Ritbit/SIGHT/SIGHT Power&Data V2.1c - Schematics & PCB/README.md

            
How to use in EasyEDA：

In the editor, open the document via: Top menu - File - Open - EasyEDA... and select the json file, then open it at the editor, you can save it into a project.

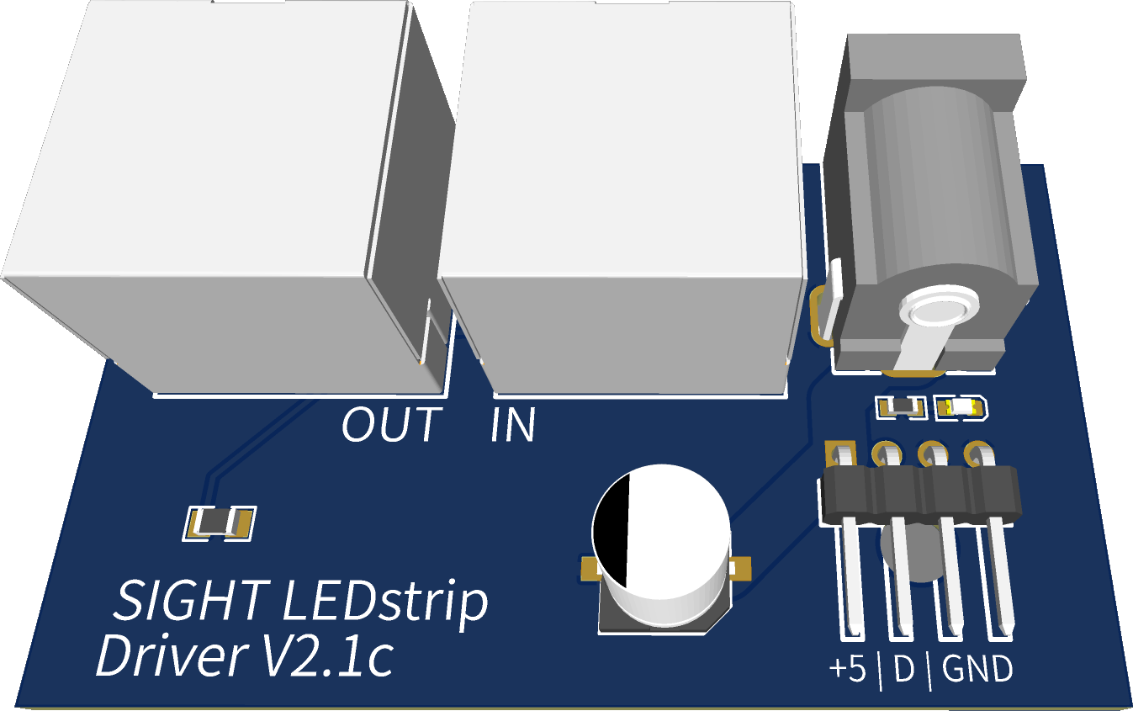
[picture p4: images/Data+Power-PCB-1.png]

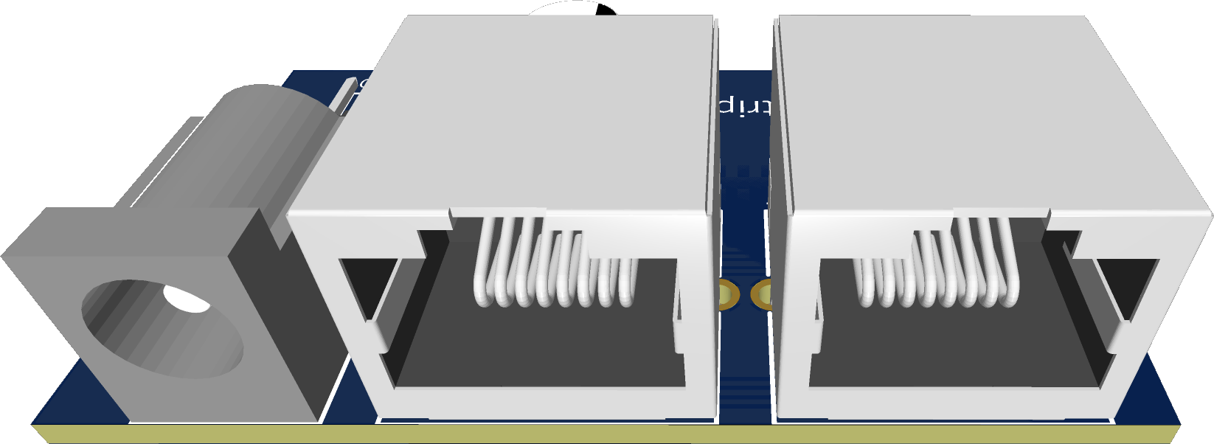
[picture p5: images/Data+Power-PCB-2.png]
