Ritbit/SIGHT/SIGHT controller V2.1c - Schematics & PCB/README.md

            
How to use in EasyEDA：

In the editor, open the document via: Top menu - File - Open - EasyEDA... and select the json file, then open it at the editor, you can save it into a project.

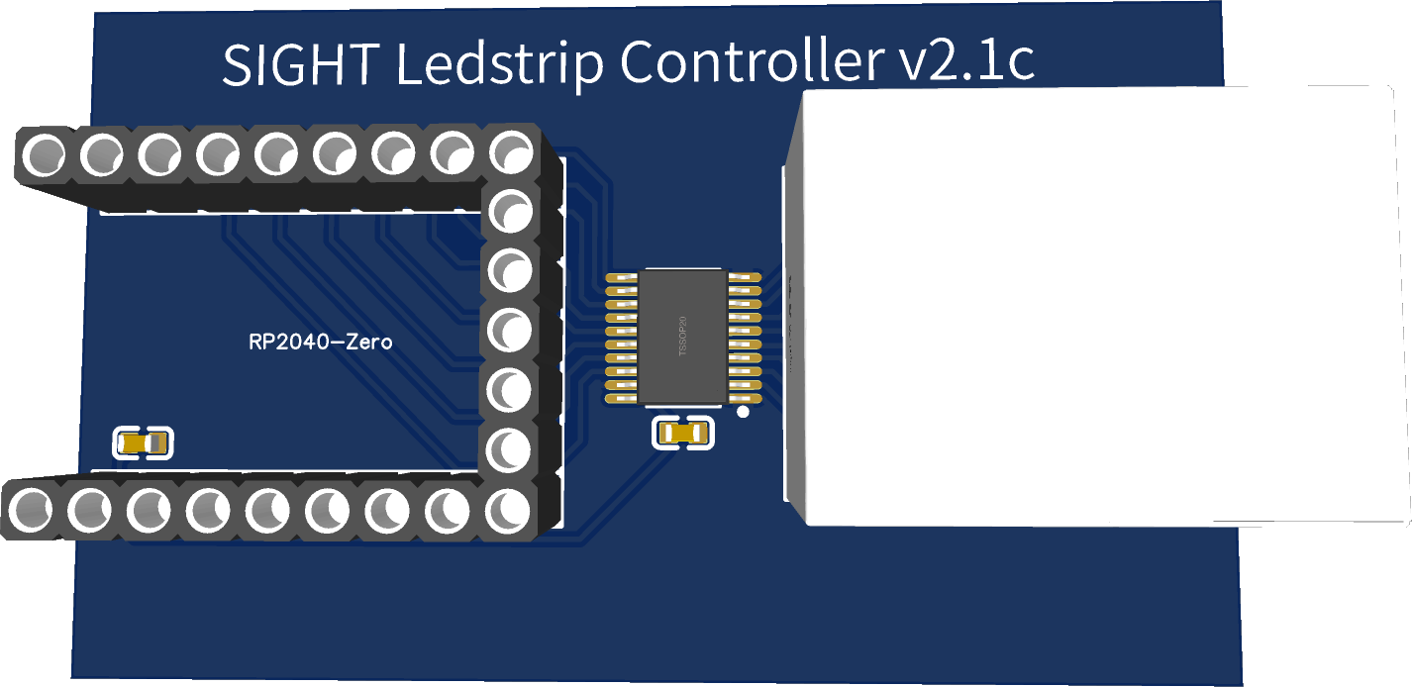
[picture p6: images/Controller-PCB.png]
Controller-PCB Zero
