Ritbit/SIGHT/images/ws2812_timing.png

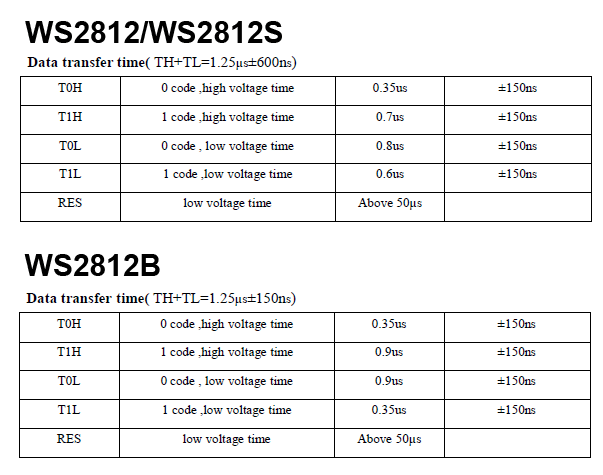
images/ws2812_timing.png
