Ritbit/SIGHT/images/testrack.jpg

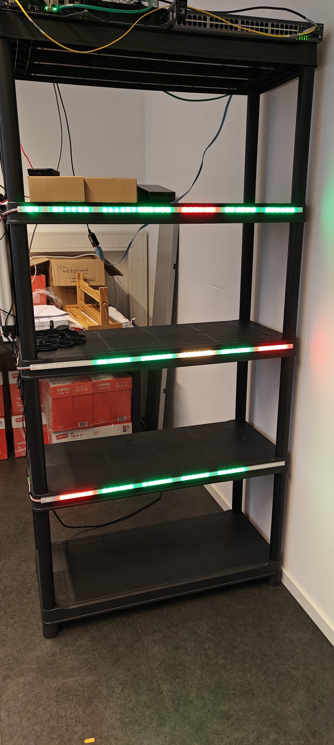
images/testrack.jpg
