Ritbit/SIGHT/SIGHT controller V2.1c - Schematics & PCB/PCB SIGHT Controller V2.1c Bottom Layer.pdf

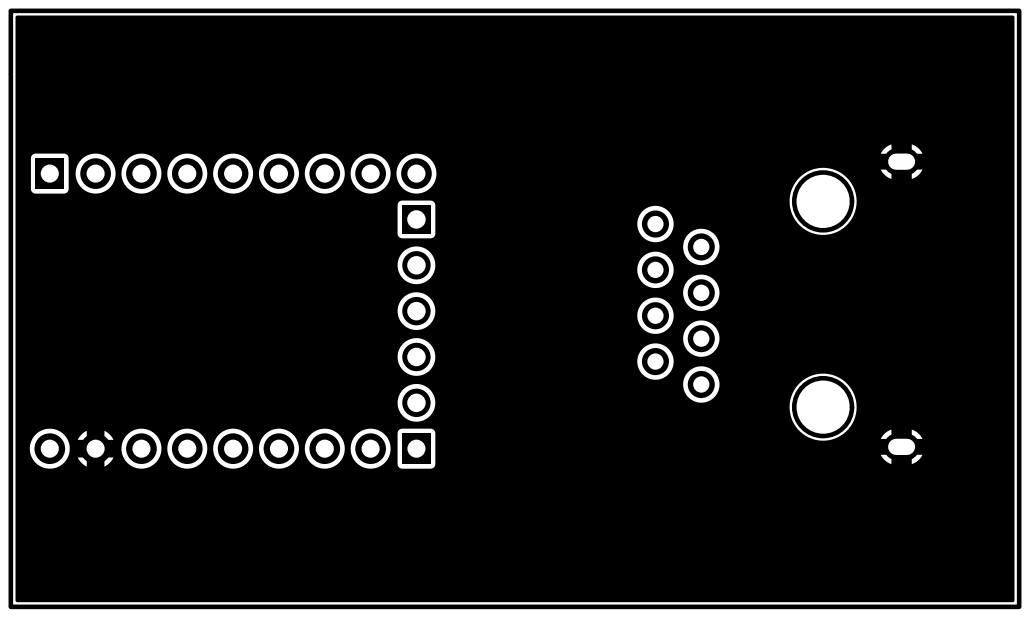
[picture p9: page 1]
