Ritbit/SIGHT/SIGHT controller V2.1c - Schematics & PCB/PCB SIGHT Controller V2.1c Top Layer.pdf

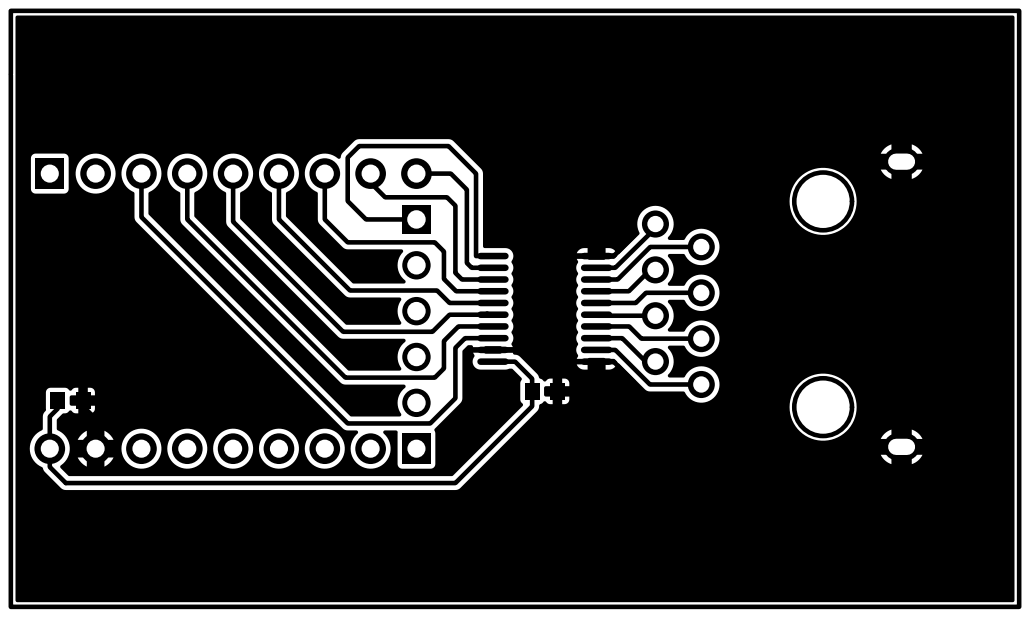
[picture p10: page 1]
