Ritbit/SIGHT/SIGHT controller V2.1c - Schematics & PCB/PCB SIGHT Controller V2.1c Top Silk Layer.pdf

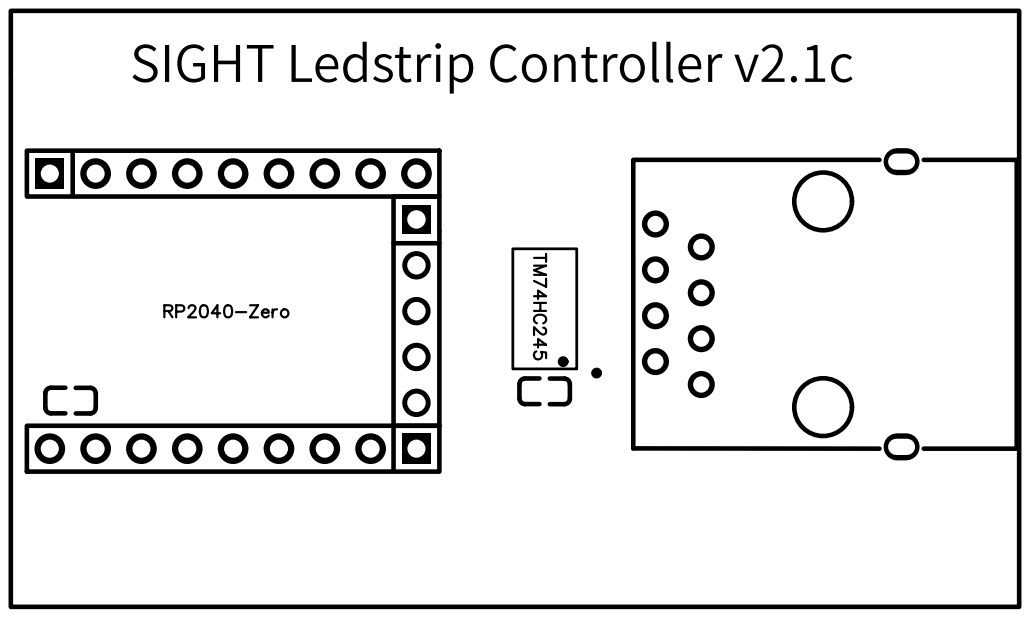
[picture p11: page 1]
