Ritbit/SIGHT/SIGHT controller V2.1c - Schematics & PCB/Schematic SIGHT Controller-V2.1c.pdf

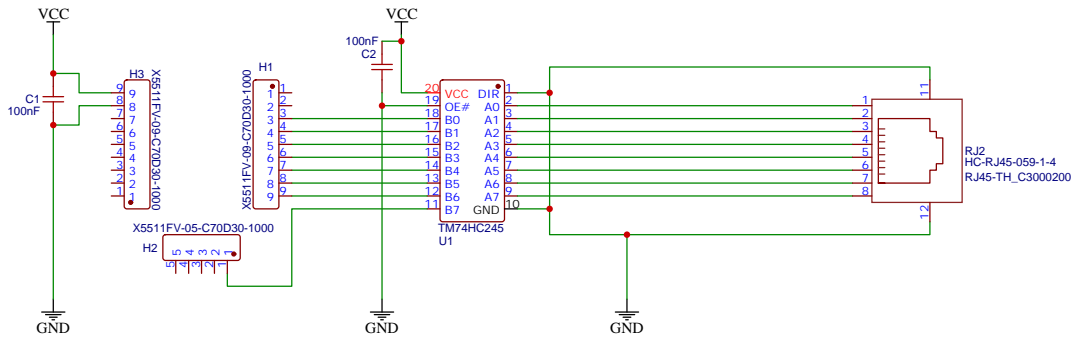
[picture p12: page 1]

Drawn By: B. van Ritbergen
