Ritbit/SIGHT/SIGHT Power&Data V2.1c - Schematics & PCB/PCB SIGHT Power&Data V2.1c Bottom Layer.pdf

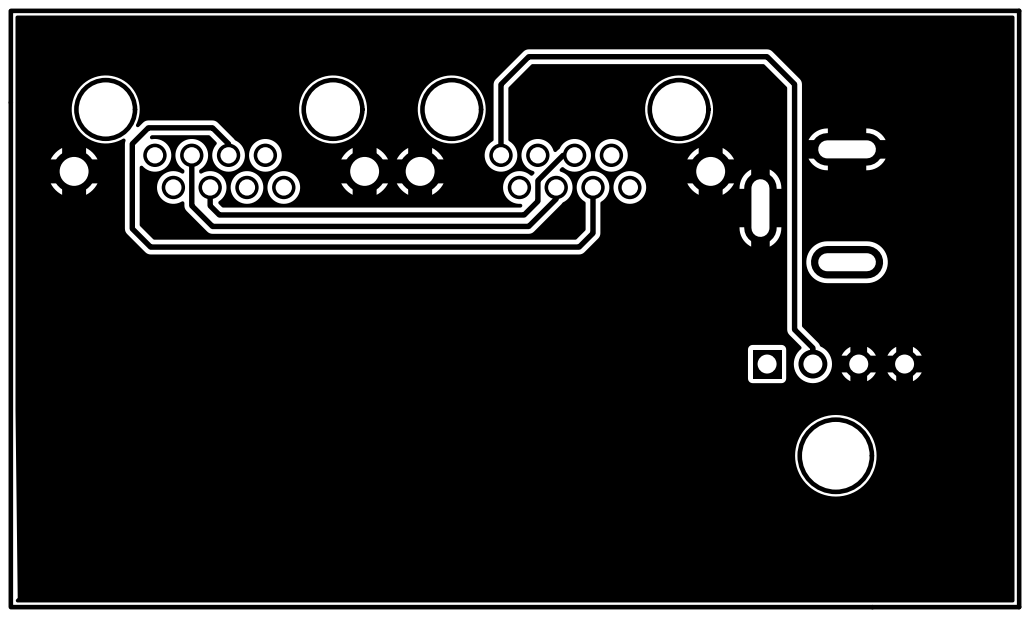
[picture p13: page 1]
