Ritbit/SIGHT/SIGHT Power&Data V2.1c - Schematics & PCB/PCB SIGHT Power&Data V2.1c Top Layer.pdf

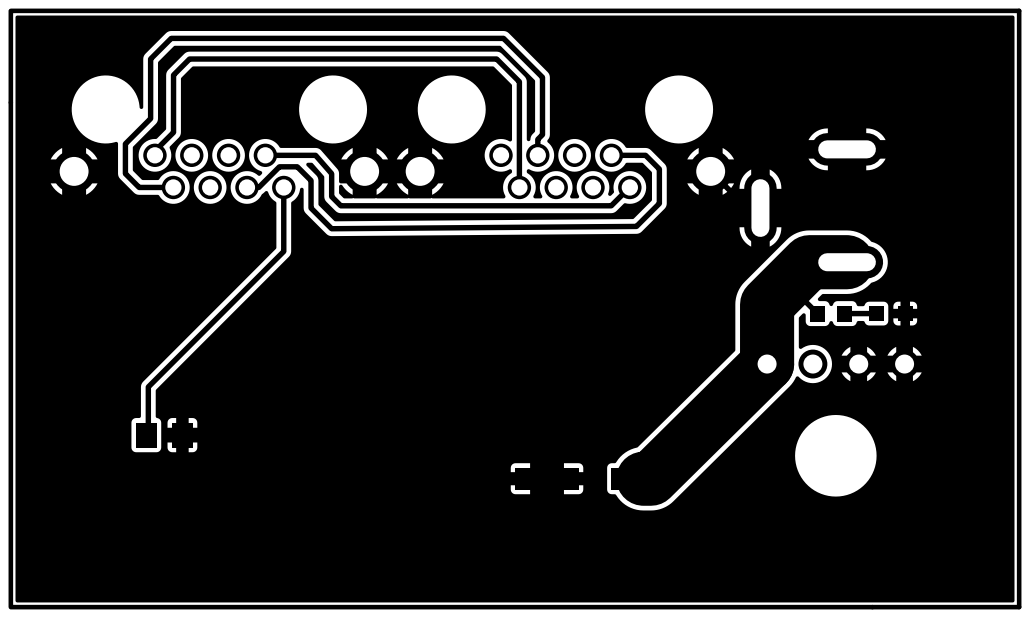
[picture p14: page 1]
