Ritbit/SIGHT/SIGHT Power&Data V2.1c - Schematics & PCB/PCB SIGHT-Power&Data V2.1c Top Silk Layer.pdf

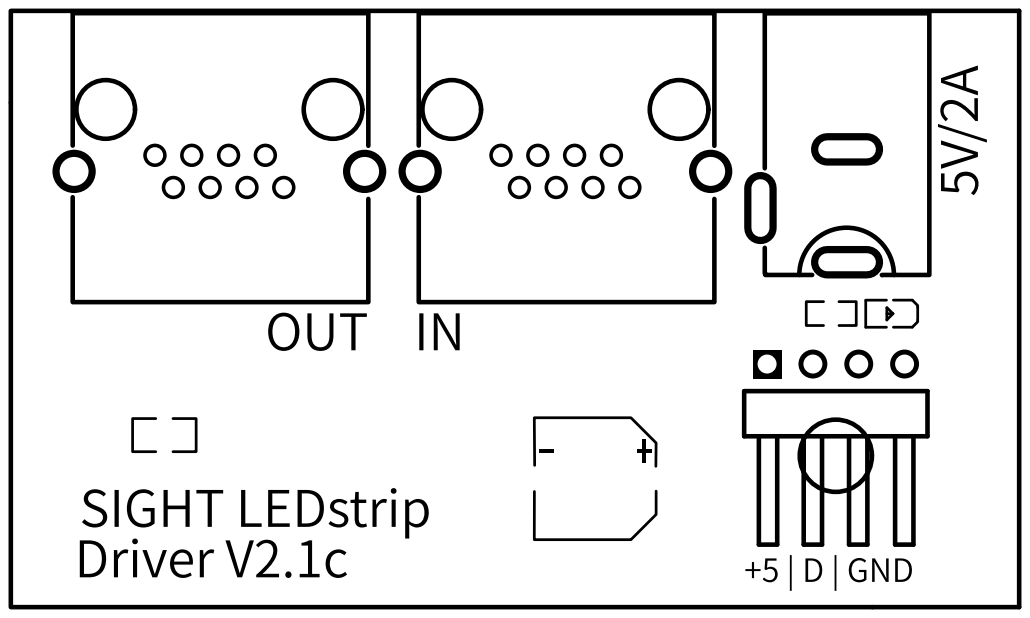
[picture p15: page 1]
