Ritbit/SIGHT/SIGHT Power&Data V2.1c - Schematics & PCB/Schematics SIGHT Power&Data V2.1c.pdf

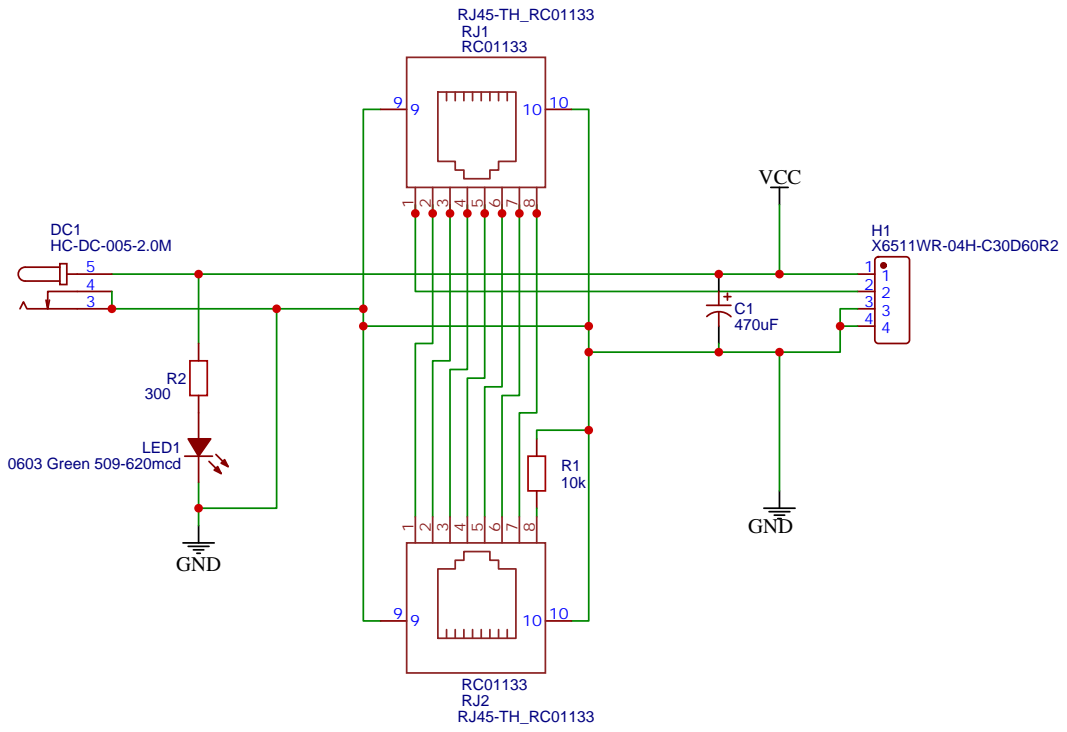
[picture p16: page 1]

Drawn By: B. van Ritbergen
