Ritbit/SIGHT/(list of files, drawings)

Other design files:
SIGHT controller V2.1c - Schematics & PCB/PCB SIGHT Controller PCB V2.1c.json
SIGHT controller V2.1c - Schematics & PCB/Schematic SIGHT controller V2.1c.json
SIGHT Power&Data V2.1c - Schematics & PCB/PCB SIGHT Power&Data PCB V2.1c.json
SIGHT Power&Data V2.1c - Schematics & PCB/Schematic SIGHT Power&Data V2.1c.json
