Ritbit/SIGHT/(commit log)

2024-10-10 Added Schematics and PCB layouts
    [PCB SIGHT Controller PCB V2.1c.json, PCB SIGHT Power&Data PCB V2.1c.json, Schematic SIGHT Power&Data V2.1c.json, Schematic SIGHT controller V2.1c.json]
2024-10-10 Added note about disfunctional RGBW LEDstrips
2024-10-14 Renamed dirs
    [PCB SIGHT Controller PCB V2.1c.json, PCB SIGHT Power&Data PCB V2.1c.json, Schematic SIGHT Power&Data V2.1c.json, Schematic SIGHT controller V2.1c.json]
2024-10-20 Some fixes and adaptations
    [sight.ino]
2024-10-20 Added ledstrip image
2024-10-21 Update PCB README.txt
2024-10-21 Renamed folders
    [PCB SIGHT Controller PCB V2.1c.json, PCB SIGHT Power&Data PCB V2.1c.json, Schematic SIGHT Power&Data V2.1c.json, Schematic SIGHT controller V2.1c.json]
2024-11-09 Renamed src to stay compatible with ArduinoIDE
2025-09-24 Changes & fixes -> 1.7beta
    [sight.ino]
2025-11-25 Fixed small bug in setting identifier.
    [sight.ino]
2025-11-25 Fixed unnecessary blank lines in output
    [sight.ino]
2025-11-26 Fix fading and cosmetic issue on show config
    [sight.ino]
2025-12-04 Fixed some spelling typos
    [sight.ino]
2026-09-28 v1.10: fix config validation, CPU LED timing, and boot-wait bugs
    - Fix group-ID truncation, geometry/division-by-zero, and unvalidated
    config load/import via a shared validateConfig()
    - Fix CPU LED bit-bang timing (was showing solid white) and restore
    indefinite serial-connect wait on boot
    - Harden serial parsers, make LittleFS/config saves safer, close an
    ISR/foreground race
    Note: a new persisted formatId field means an existing config.bin saved
    by older firmware will be flagged/reset to defaults on first boot after
    upgrading; use 'S' to save a fresh config afterward.
    [sight.ino]
2026-09-28 v1.11: field-wise persistence, reboot confirmation, hardware-verified CPU LED/RGBW timing
    - Replace raw-struct Se/Li/flash persistence with field-wise encodeConfig()/decodeConfig()
    - Cl/Cx now ask to save+reboot (Y/N) instead of a passive notice or auto-reboot
    - CPU LED timing hardware-verified in spec with a DIY logic analyzer; fixed a real bug found along the way (redundant frame resend) and reverted an optimization that broke real hardware
    - Added CPULED_COLOR_ORDER: two spare boards needed GRB, not RGB, for their onboard chip (genuine hardware variance)
    - RGBW wire order hardware-verified as G,R,B,W; documented that LED_COLOR_ORDER doesn't control it
    - FastLED_RGBW.h dead-code cleanup
    [sight.ino]
2026-09-28 Clarify the reboot Y/N prompt's fallback comment
    The comment claimed an unrecognized answer "falls through" to be
    parsed as a normal command, but the unconditional return right after
    the if/else-if/else discards the line instead. Fix the comment to
    describe what actually happens.
    [sight.ino]
2026-09-28 Fix V command's misleading RGBW color order string
    V echoed LED_COLOR_ORDER's value (RGB) as the RGBW wire color order,
    but that define has no effect in RGBW mode -- FastLED.addLeds() is
    called with a (CRGB*)-cast CRGBW buffer, so its color-order swap never
    sees the real 4-byte layout. Print the real, hardware-verified fixed
    order (GRBW, from CRGBW's field declaration order) instead.
    [sight.ino]
2026-09-28 Flag Li:CONFIG: imports that change LED count or GPIO pins for reboot
    Cl/Cx ask to save+reboot when changed interactively, because FastLED's
    controllers are registered once at boot. Importing a whole config via
    Li:CONFIG: could change those same two fields but only got a generic
    S/R reminder. Compare the imported (and validated) values against the
    live config before overwriting, and use the same promptSaveAndReboot()
    flow as Cl/Cx when either actually changed.
    [sight.ino]
2026-09-28 Fix animate_Step[] race in patterns 8-12
    boundAnimateStep() bounds an animate_Step[] element atomically, but
    patterns 8-12 then re-read animate_Step[pattern] directly afterward
    (unprotected) to compute an LED index. The animateStep() ISR can fire
    in that gap and drift the value 1 past the bound just applied, which
    in the worst case (last group in a channel, numLedsPerChannel at max)
    is a narrow out-of-bounds write.
    Have boundAnimateStep() return the bounded value and have every caller
    use that local instead of re-reading the array.
    [sight.ino]
2026-09-28 Validate combined LED strip geometry in Cl/Ct/Cw/Co
    Each of these setters only range-checked its own value, not the
    combined geometry invariant (positive segment width, spacer narrower
    than the segment, last group within numLedsPerChannel) that
    validateConfig() enforces elsewhere. A sequence of individually-valid
    commands could leave LedConfig in a combination validateConfig() would
    have rejected -- setLEDGroup()'s render-time bounds check kept this
    from corrupting memory, but rendering could silently go wrong.
    Extract the combined-geometry check into isValidGeometry(), share it
    with validateConfig(), and reject the change from Cl/Ct/Cw/Co with the
    proposed value substituted in if the resul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
    [sight.ino]
2026-09-28 Don't bump CONFIG_IDENTIFIER for v1.11 -- layout is unchanged from v1.10
    v1.11 replaced raw-struct persistence with an explicit field-wise
    encodeConfig()/decodeConfig(), but that only changed the serialization
    mechanism, not the actual LedData layout: the struct is byte-for-byte
    identical to v1.10 (same fields, same order, same types), and
    sizeof(LedData) == CONFIG_WIRE_SIZE == 112 with no padding, verified at
    compile time. So the previous CONFIG_IDENTIFIER bump to
    "SIGHT-CFG1.11" wasn't backed by an actual incompatibility -- it just
    made validateConfig() flag every existing v1.10 config.bin as a
    "format identifier mismatch" and print a misleading "Some Values were
    out of range and corrected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
    [sight.ino]
2026-09-29 v1.12: native FastLED RGBW support, live RGB/RGBW + LED-count switching
    - Replace the compile-time USE_RGB_LEDS/USE_RGBW_LEDS toggle and the
    hand-rolled FastLED_RGBW.h CRGB-cast hack with FastLED's own native
    RGBW support (CLEDController::setRgbw()/clearWhiteChannel(), checked
    fresh on every show() by the RP2040 PIO driver). One firmware build
    now supports both modes; leds[][] is always plain CRGB.
    - New Cm:RGB/Cm:RGBW command switches strip mode live, no reboot.
    LED_COLOR_ORDER is now genuinely honored in RGBW mode (it wasn't
    before, under the old cast hack). RGBW uses kRGBWExactColors:
    extracts the shared gray component into W and subtracts it from
    R/G/B, reducing current d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
    [sight.ino]
2026-09-29 Make CPU LED color order runtime-configurable and persisted
    CPULED_COLOR_ORDER (RGB/GRB, for the onboard status LED chip) was
    compile-time only, requiring a recompile+reflash whenever a board's
    onboard chip variance was found. Added LedData.cpuLedColorOrder plus a
    new Cq:RGB/Cq:GRB command so this can be corrected with one command +
    S, no rebuild needed -- sendRGB_CPULED() now branches on the runtime
    field instead of an #if. CPULED_COLOR_ORDER stays as the compile-time
    default (used by resetToDefaults() and validateConfig()'s fallback).
    LedData gains a field, so CONFIG_WIRE_SIZE grew 113 -> 114 bytes;
    encodeConfig()/decodeConfig()/validateConfig()/resetToDefaults() all
    updated to match. Ver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
    [sight.ino]
2026-09-29 Update README for v1.12: single-build RGBW, new commands, version history
    - LED strip type is now a runtime Cm:RGB/Cm:RGBW command instead of a
    firmware #define; removed the now-nonexistent FastLED_RGBW library
    from the install list
    - Fixed the command reference: replaced the long-broken C4: entry with
    Cm:/Cq:, and noted which commands still require a reboot
    - Updated the sample boot/config output to match current firmware
    (v1.12 field names, default values)
    - Added version history sections for v1.10, v1.11, and v1.12 (was
    stuck at v1.9.1)
2026-09-29 Fix 4 issues found by a post-release CodeRabbit audit
    - animate_Step[] was uint8_t, capping chase-pattern animation at 255
    steps: boundAnimateStep()'s "% modulus" became a no-op whenever
    modulus (e.g. groupWidth*2 for pattern 10) reached 256+, permanently
    truncating patterns 8/9/10/12 on wide LED groups. Widened
    animate_Step/boundAnimateStep()'s return/the setLEDGroup() step
    locals to uint16_t, and fixed animateStep()'s init loop to iterate
    array elements instead of raw bytes (was relying on
    sizeof(animate_Step) counting single-byte elements).
    - Li:CONFIG: import, the runtime L reload, and Cd only called
    applyLedCount()/applyLedMode() after replacing the whole LedConfig,
    un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
    [sight.ino]
2026-09-29 Fix stale default LED count in README sample boot output
    The sample output still showed 57 (the old NUM_LEDS_PER_CHANNEL_DEFAULT)
    after it was changed to 60 in sight.ino.
2026-09-29 Address review remarks: dead variable, stale changelog entries
    - Removed unused CRGB color local in StartupLoop() (assigned but never
    read -- the loop uses CRGB::Green directly instead; source of a
    recurring compiler warning throughout this session)
    - sight.ino's own v1.12 changelog header was missing the Cq:/
    cpuLedColorOrder command and the post-release CodeRabbit audit fixes
    (animate_Step widening, applyRuntimeConfig()) -- both already shipped
    in the V1.12 release, just undocumented there
    [sight.ino]
